Praveen-Raj-u-s/SwitchLink/README.md

# SwitchLink

SwitchLink is a Smart Switch Control Unit that goes beyond conventional remote switch control. It features a Smart USB charging system utilizing an OP Amp comparator to detect the full-charge status of connected devices. This feature is especially useful for devices and appliances lacking built-in Charge Protection Circuitry. When a device reaches full charge, SwitchLink notifies the user with defined acoustic notifications generated by a Piezo-buzzer via PWM.

## Key components and functionalities include:

* Smart USB Charging System: Monitors and indicates full-charge status using an OP Amp comparator.
* Acoustic Notifications: Utilizes a Piezo-buzzer controlled through PWM to notify users when charging is complete.
* Relay Module: Enables control of electrical switches.
* Proximity Sensors: Provides a non-contact user interface for switch control.
* Remote Control: Allows switching control over the Internet using MQTT.
* SwitchLink enhances the usability and safety of home appliances and devices, providing both manual and remote control options.

Bill of Materials: https://github.com/Praveen-Raj-u-s/SwitchLink/blob/main/Bill%20of%20Materials.BomDoc

## Critical Components:

Microcontroller (MCU):
SAMW25 Xplained Pro: This microcontroller handles all processing tasks, including sensor data acquisition, control logic, and communication. It is integrated with FreeRTOS for real-time task management and efficient operation.

image-removebg-preview

Sensors:

* VL6180X Proximity Sensors: Two proximity sensors are used for non-contact switch control. These sensors detect the presence of a hand or object near the switch, allowing for gesture-based control of the connected devices.

image-removebg-preview (1)

* OP Amp Comparator: Used in the Smart USB charging system to detect the full-charge status of connected devices. This comparator monitors the voltage level and triggers notifications when the device is fully charged.

image-removebg-preview (2)

Actuators:

* Relay Module: Controls the switching of electrical devices. The relay module is activated based on inputs from the proximity sensors or remote commands received over the Internet.

* Piezo-buzzer: Generates acoustic notifications when a device connected to the USB charging system is fully charged. The buzzer is controlled using PWM signals to create different sound patterns.

Communication Module:

 * MQTT Protocol: Enables remote control and monitoring of the switches over the Internet. The device connects to an MQTT broker, allowing users to send commands and receive status updates from anywhere with Internet access.

Power Management:

* LDO: MCP1700T converts the input of 3.3V to 4.2V to 2.8V and supplies to the VL6180X sensor whose ideal working voltage is 2.8V.

image-removebg-preview (3)

* Buck Converter: TPS62082DSGR supplies to most of the compoents a stable 3.3V from the 3.3V to 4.2V input.

image-removebg-preview (4)

## Block Diagram:



## Functional Workflow:

* Power Up: The device initializes, and the PMIC ensures stable power distribution to all components.
* Sensor Monitoring: The proximity sensors continuously monitor for user gestures to control the switches.
* Charge Detection: The OP Amp comparator monitors the voltage level of connected devices.
* User Interaction: When a proximity sensor detects a hand gesture, it sends a signal to the MCU, which activates the corresponding relay to turn the device on or off.
* Remote Commands: Users can send commands via the Internet using the MQTT protocol, allowing remote control of the switches.
* Notifications: When a device reaches full charge, the OP Amp comparator triggers the Piezo-buzzer to notify the user acoustically.

## PCB Designing:

Altium Designer was leveraged for Footprint Creation, Schematic Capture, layout, Workmanship, Gerber File generation etc.

Altium Project Link: https://upenn-eselabs.365.altium.com/designs/0D535367-1C3A-4320-998F-776AB24CDA05

## Schematics:

Main Sheet:

Switchlink Schematics-01

Memory:
  
Switchlink Schematics-02

MCU:

Switchlink Schematics-03

USB to Serial FTDI:

Switchlink Schematics-04

LIPO Charger:

Switchlink Schematics-05

Buck Converter:

Switchlink Schematics-06

Piezo-Buzzer:

Switchlink Schematics-07

LDO:

Switchlink Schematics-08

Proximity Sensor:
  
Switchlink Schematics-09

USB-C Receptor:
  
Switchlink Schematics-11

## PCB Simulation:

2D:



3D: 



## Fabrication & Assembly Files (Draftsmanship):

File Link: https://github.com/Praveen-Raj-u-s/SwitchLink/tree/main/Draftsmanship

## PCB Fabricated:

Top:





Bottom:

WhatsApp Image 2024-05-14 at 21 51 46_9ab4633a

## PCB Testing:

### Power System Evaluation:

#### Distinct Power Modes:

The device has two power sources: single cell LiPo and USB power. It has one regulator: a 3.3V buck and an LDO to provide a 2.8V for the proximity sensors. My distinct power modes would be:

Unregulated battery only is connected and ranges from 3.30V to 4.20V
Regulated USB only is connected and ranges from 4.85V to 5.25V
Both battery and USB are connected, so the USB voltage will be preferred (4.85-5.25V)

#### Power Regulation Evaluation: 

We want to determine how well (if at all!) the PCBA power regulation circuitry is working. We’ll leverage the oscilloscopes in the lab to capture various critical modes. Key questions we’ll be answering in this section are:

Are there any critical failures (i.e shorting, over voltage, etc.)?

Are we generating the voltage we expected?

Is the ripple on the output acceptable?

Setup for Evaluation:



Oscilloscope capture of the startup transient of the regulated output:



Oscilloscope capture of the steady state of the regulated output:



#### E-load testing:

We’ll load test our riskiest regulation circuit. We do not need to do load testing on all of our power regulation circuits! Only the one that is the highest risk. For example, if I have a 3.3V buck or a 12V boost, I would be more concerned about the large change in voltage required for the 12V boost.

For a chosen regulation circuit, we review our expected current load. Then, use the E-Load to evaluate the following conditions: 10%, 50%, 100%, and 120% of the expected current load. The E-Load will be measuring the actual voltage with the applied load - this is what we want to log.

logged Values: [E-Load Test Values.xlsx](https://github.com/Praveen-Raj-u-s/SwitchLink/files/15317090/E-Load.Test.Values.xlsx)

#### Thermal Evaluation under load:

With our device under load, we take an image using the thermal camera.

10% Load:



50% Load:



#### Programming the board:

JLink Debugger Connection:



Device Programming in Atemel Microchip Studio:



#### Peripheral Testing:

Now that we can program our PCBA, it is time to start bringing up the peripherals in your system. Typically, we bring the systems online one by one. For each of these following steps, we may run into failures. In such failures, we review our firmware and Altium hardware files to try to find issues. We Use the debugging tools in the lab to check for voltage, analyze serial communication, etc.

## Programming:

We use FreeRTOS for the whole implementation owing to its concurrency capabilities.

Atmel Microchip Studio Project: https://github.com/Praveen-Raj-u-s/SwitchLink/tree/main/Code%20-%20Atmel%20Microchip%20Studio%20Project

## 3D Design:

I did the CAD design in Autodesk Fusion 360 
