Praveen-Raj-u-s/SwitchLink/Schematics/Switchlink Schematics-01.png

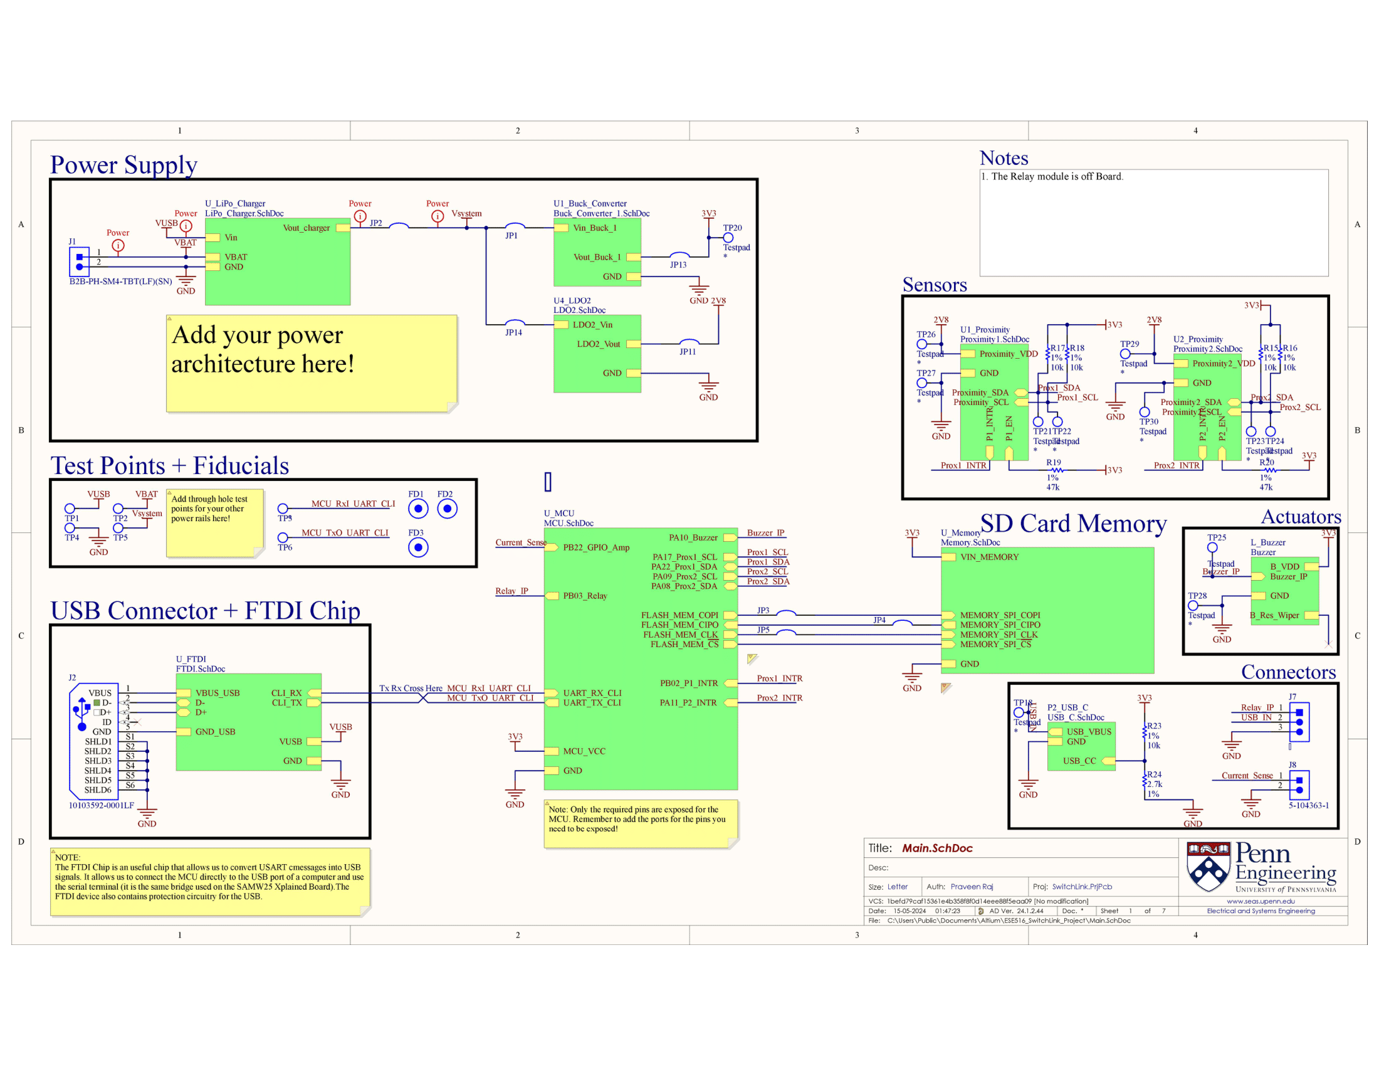
Schematics/Switchlink Schematics-01.png
