Praveen-Raj-u-s/SwitchLink/Schematics/Switchlink Schematics-02.png

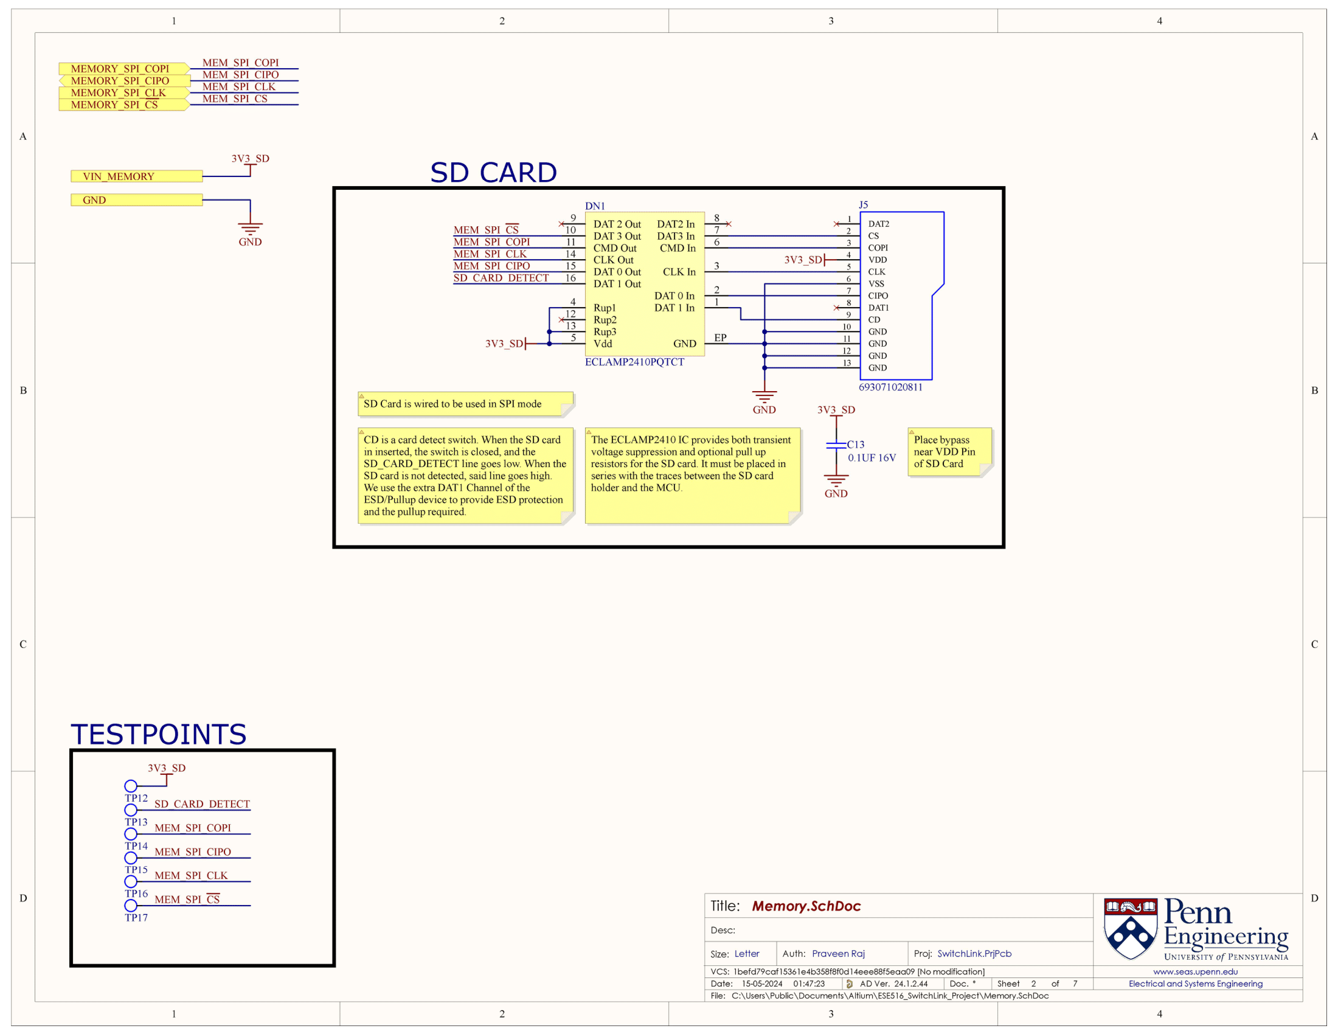
Schematics/Switchlink Schematics-02.png
