Praveen-Raj-u-s/SwitchLink/Schematics/Switchlink Schematics-03.png

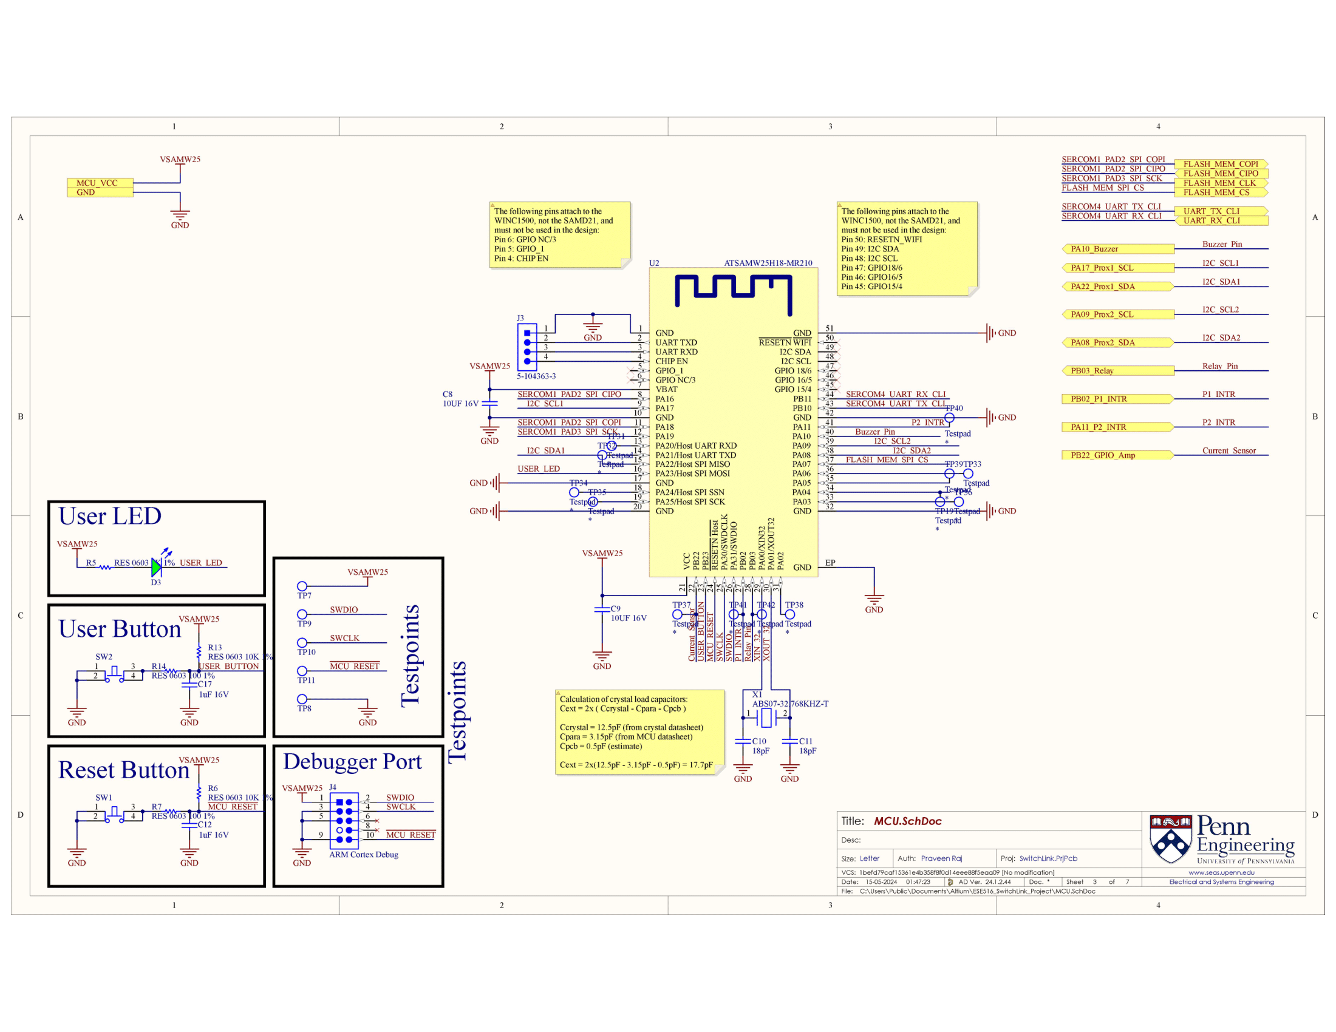
Schematics/Switchlink Schematics-03.png
