Praveen-Raj-u-s/SwitchLink/Schematics/Switchlink Schematics-04.png

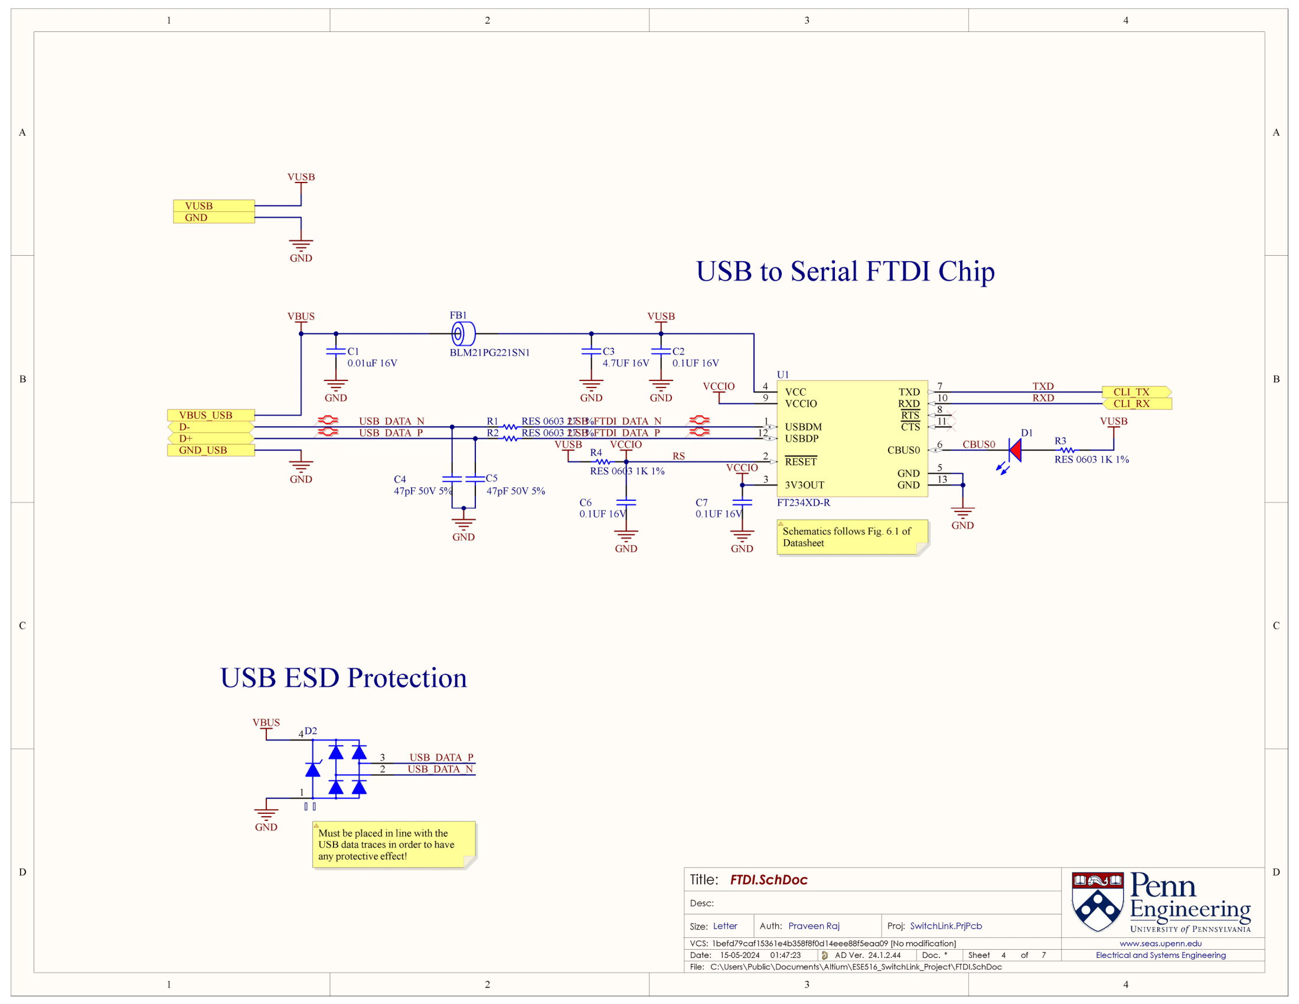
Schematics/Switchlink Schematics-04.png
