Praveen-Raj-u-s/SwitchLink/Schematics/Switchlink Schematics-05.png

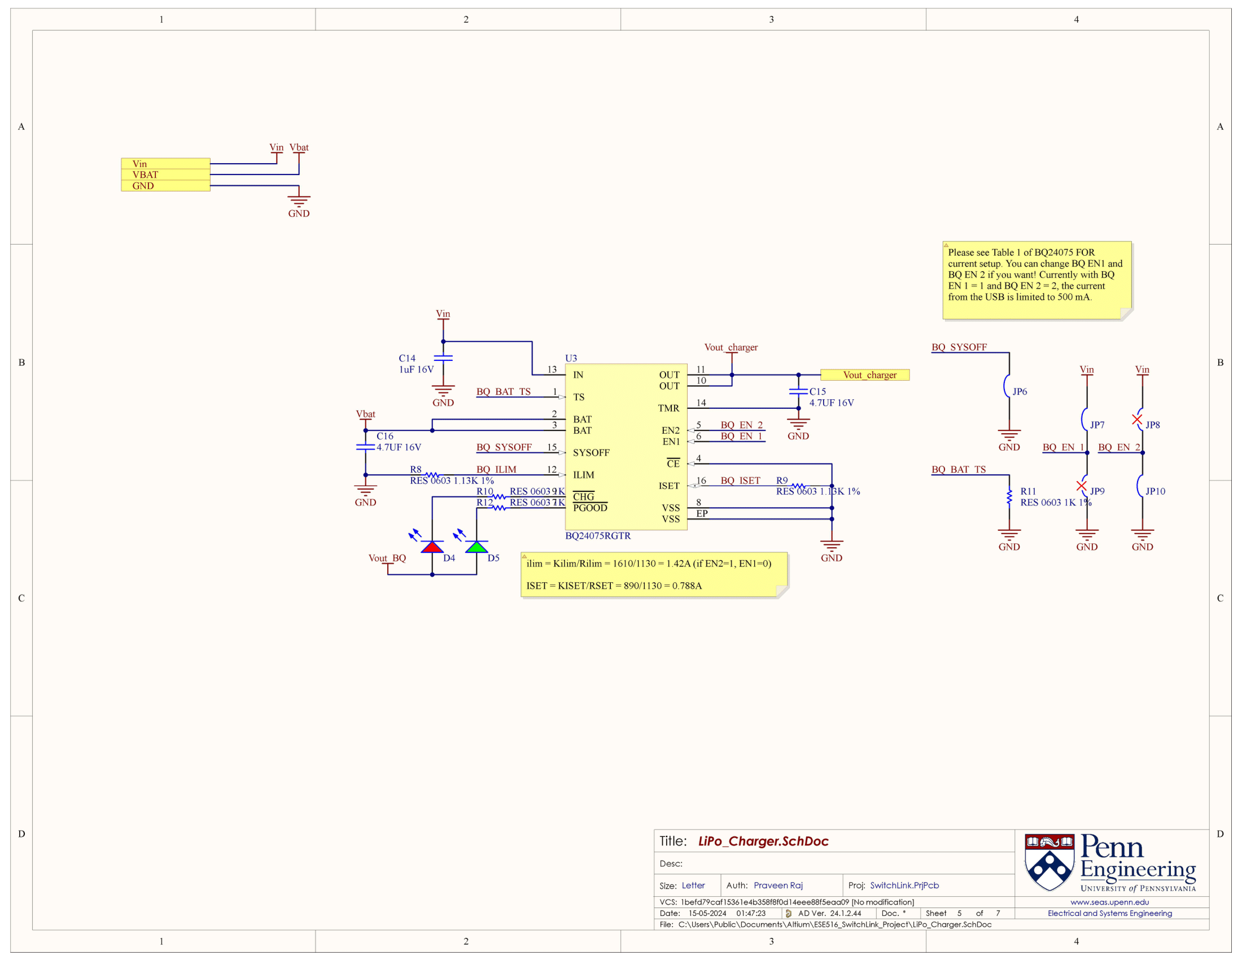
Schematics/Switchlink Schematics-05.png
