Praveen-Raj-u-s/SwitchLink/Schematics/Switchlink Schematics-06.png

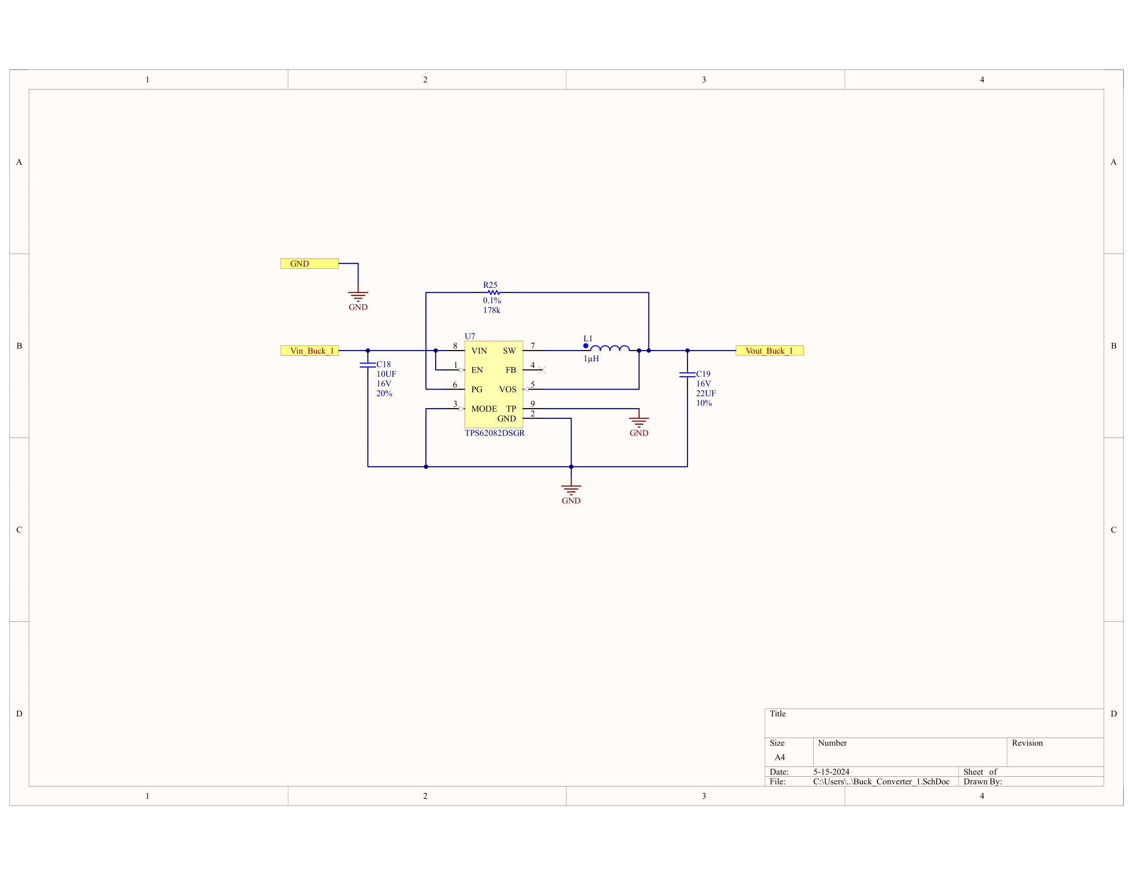
Schematics/Switchlink Schematics-06.png
