Praveen-Raj-u-s/SwitchLink/Schematics/Switchlink Schematics-07.png

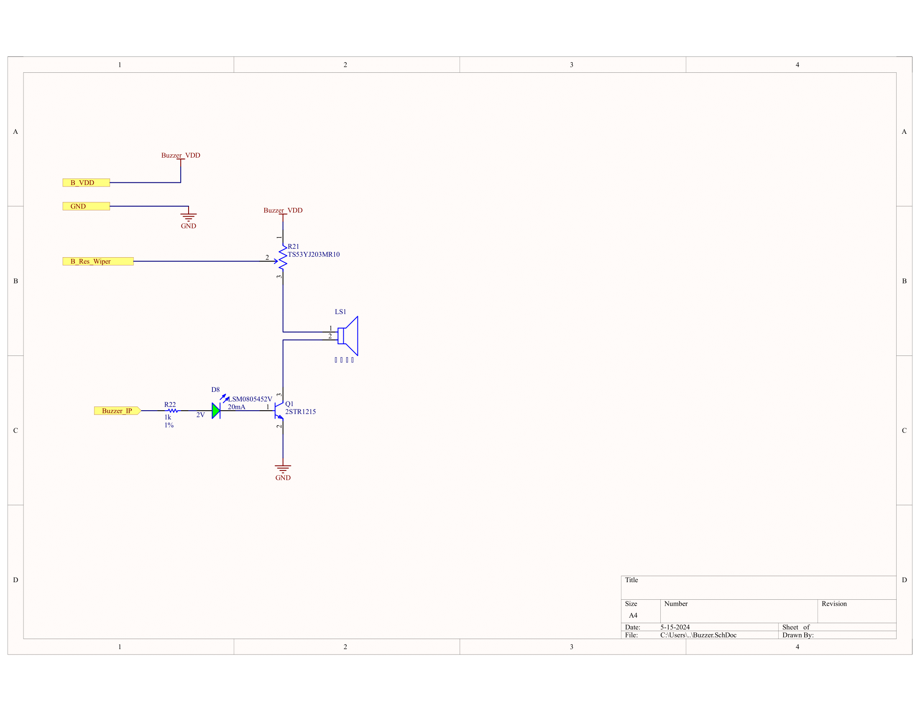
Schematics/Switchlink Schematics-07.png
