Praveen-Raj-u-s/SwitchLink/Schematics/Switchlink Schematics-08.png

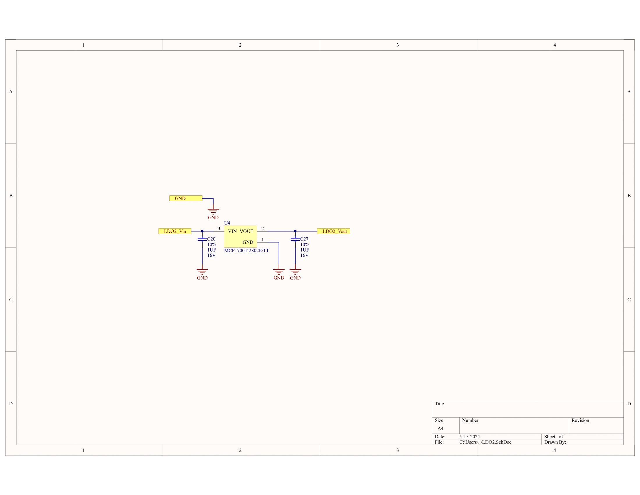
Schematics/Switchlink Schematics-08.png
