Praveen-Raj-u-s/SwitchLink/Schematics/Switchlink Schematics-09.png

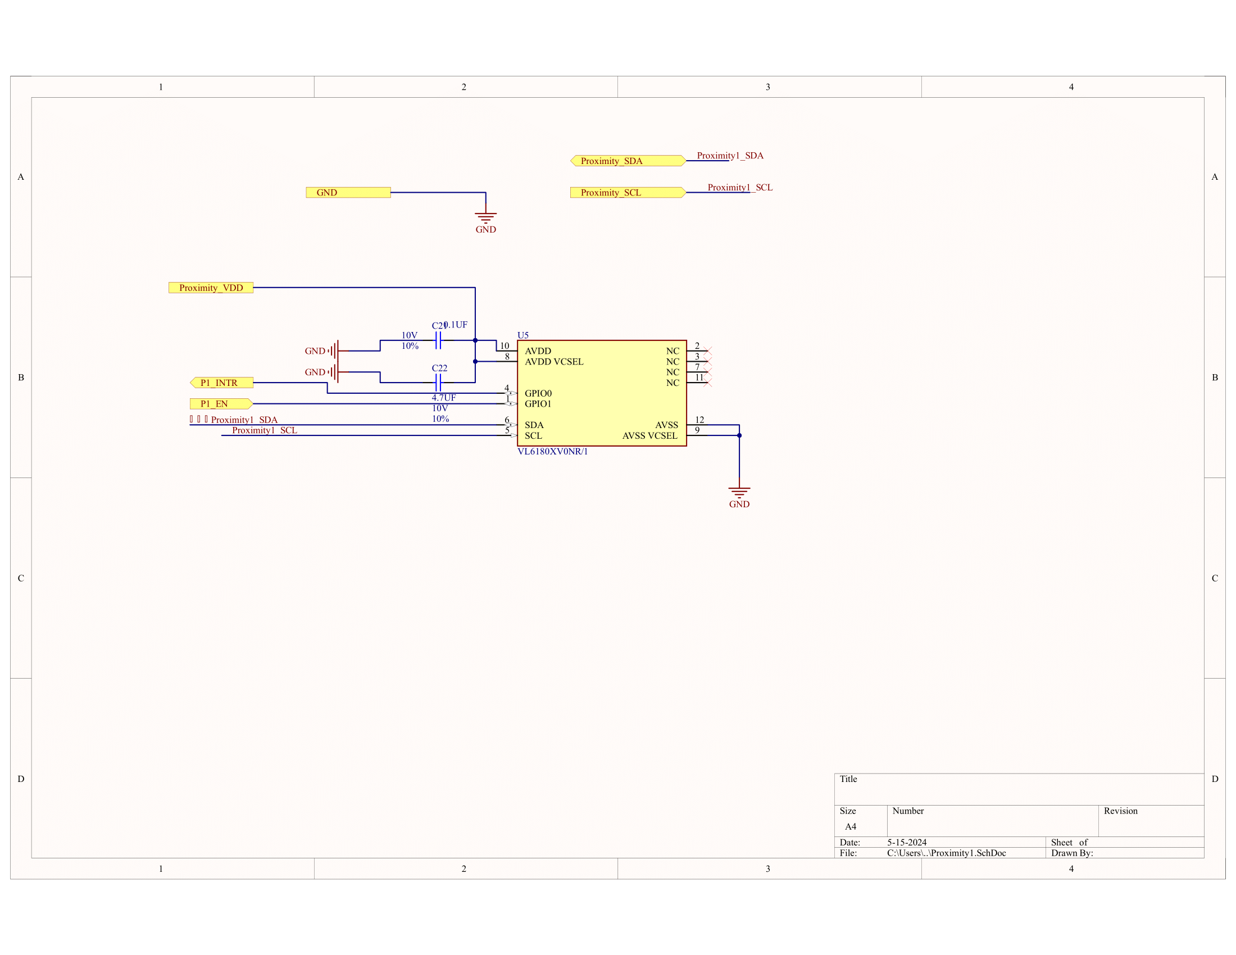
Schematics/Switchlink Schematics-09.png
