Praveen-Raj-u-s/SwitchLink/Schematics/Switchlink Schematics-10.png

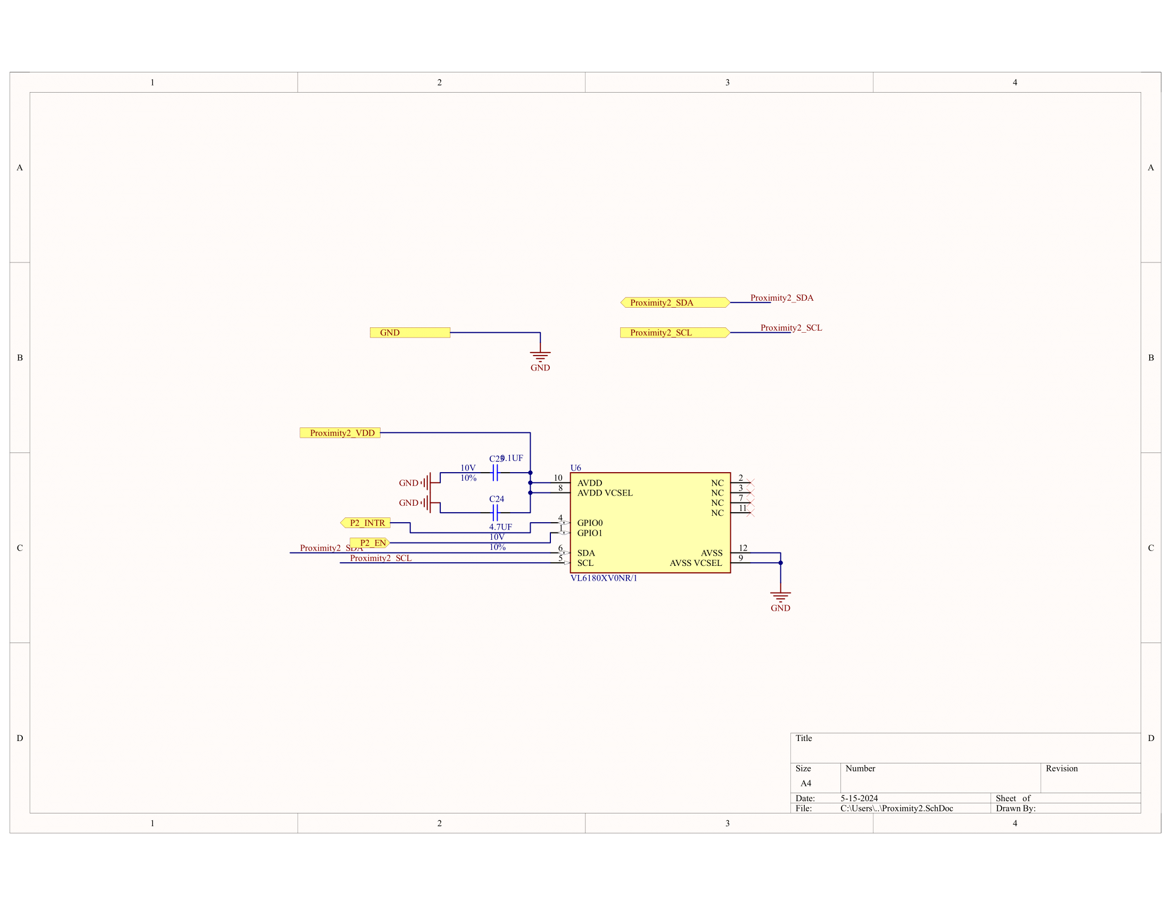
Schematics/Switchlink Schematics-10.png
