Praveen-Raj-u-s/SwitchLink/Schematics/Switchlink Schematics-11.png

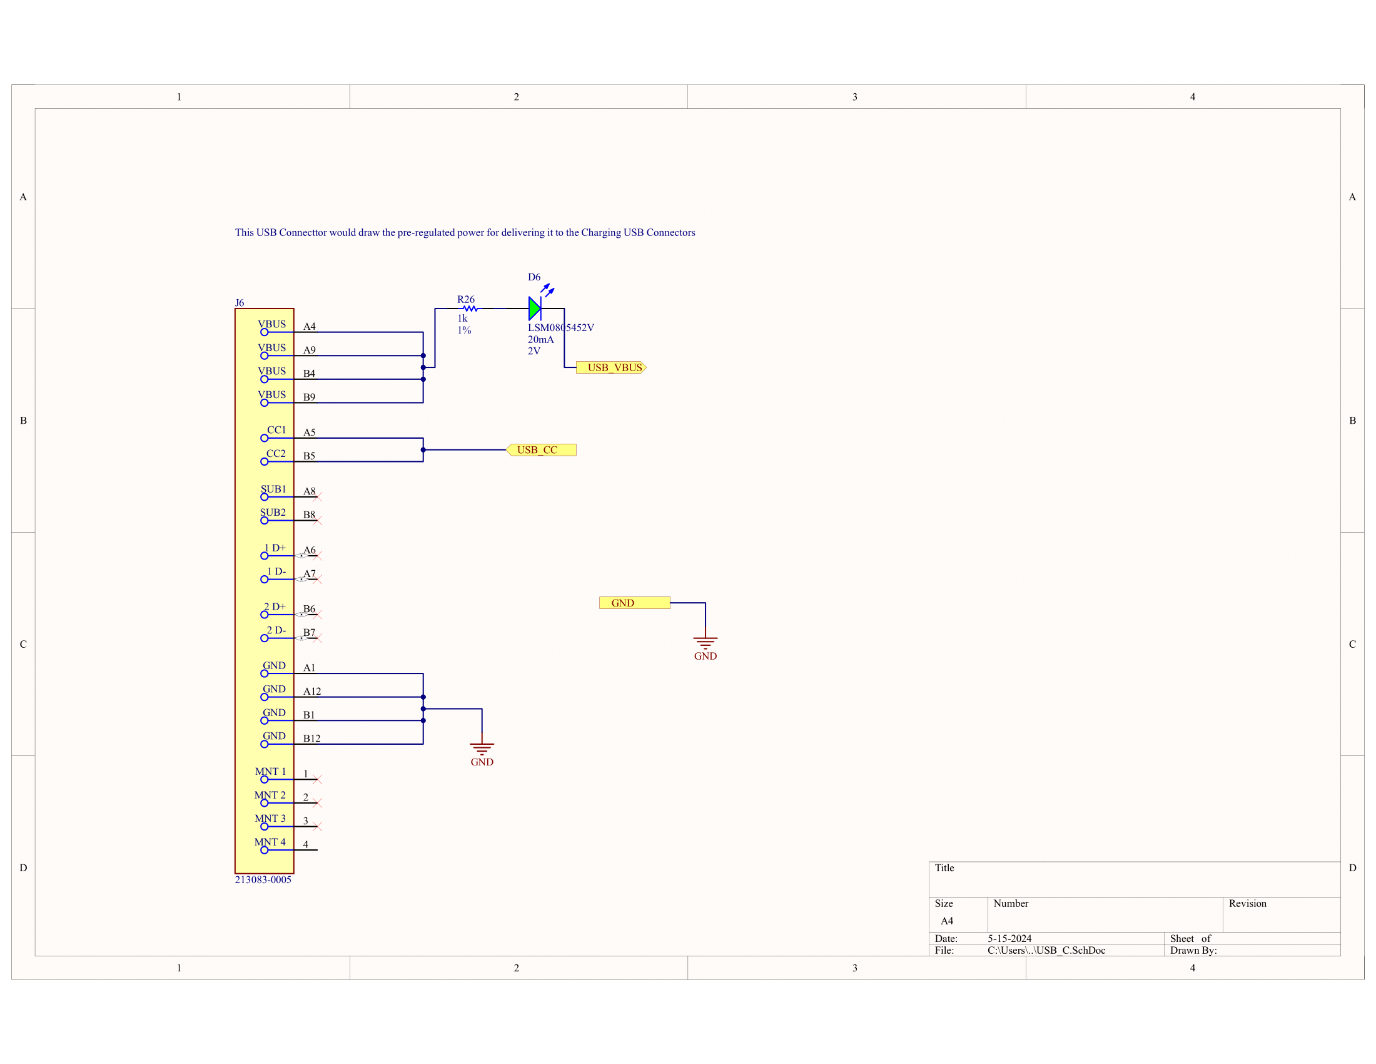
Schematics/Switchlink Schematics-11.png
