Praveen-Raj-u-s/SwitchLink/Code - Atmel Microchip Studio Project/Application/src/SerialConsole/SerialConsole.c

/**
 * @file        SerialConsole.c
 * @ingroup 	   Serial Console
 * @brief       This file has the code necessary to run the CLI and Serial Debugger. It initializes an UART channel and
 *uses it to receive command from the user as well as print debug information.
 * @details     This file has the code necessary to run the CLI and Serial Debugger. It initializes an UART channel and
 *uses it to receive command from the user as well as print debug information.
 *
 *				The code in this file will:
 *				--Initialize a SERCOM port (SERCOM # ) to be an UART channel operating at 115200 baud/second,
 *8N1
 *				--Register callbacks for the device to read and write characters asynchronously as required by
 *the CLI
 *				--Initialize the CLI and Debug Logger data structures
 *
 *				Usage:
 *
 *
 * @copyright
 * @author
 * @date        January 26, 2019
 * @version		0.1
 */

/**************************
 * Includes
 **************************/
#include "SerialConsole.h"

#include "CliThread/CliThread.h"

/**************************
 * Defines
 **************************/
#define RX_BUFFER_SIZE 512  ///< Size of character buffer for RX, in bytes
#define TX_BUFFER_SIZE 512  ///< Size of character buffers for TX, in bytes

char debugBuffer[128];

/**************************
 * Structures and Enumerations
 **************************/
cbuf_handle_t cbufRx;  ///< Circular buffer handler for receiving characters from the Serial Interface
cbuf_handle_t cbufTx;  ///< Circular buffer handler for transmitting characters from the Serial Interface

char latestRx;  ///< Holds the latest character that was received
char latestTx;  ///< Holds the latest character to be transmitted.

/**************************
 *  Callback Declaration
 **************************/
void usart_write_callback(struct usart_module *const usart_module);  // Callback for when we finish writing characters to UART
void usart_read_callback(struct usart_module *const usart_module);   // Callback for when we finis reading characters from UART

/**************************
 * Local Function Declaration
 **************************/
static void configure_usart(void);
static void configure_usart_callbacks(void);

/**************************
 * Global Local Variables
 **************************/
struct usart_module usart_instance;
char rxCharacterBuffer[RX_BUFFER_SIZE];                 ///< Buffer to store received characters
char txCharacterBuffer[TX_BUFFER_SIZE];                 ///< Buffer to store characters to be sent
enum eDebugLogLevels currentDebugLevel = LOG_INFO_LVL;  ///< Variable that holds the level of debug log messages to show. Defaults to showing all debug values

/**************************
 * Global Functions
 **************************/

/**
 * @fn			void InitializeSerialConsole(void)
 * @brief		Initializes the UART - sets up the SERCOM to act as UART and registers the callbacks for
 *				asynchronous reads and writes.
 * @details		Initializes the UART - sets up the SERCOM to act as UART and registers the callbacks for
 *				asynchronous reads and writes.
 * @note			Call from main once to initialize Hardware.
 */

void InitializeSerialConsole(void)
{
    // Initialize circular buffers for RX and TX
    cbufRx = circular_buf_init((uint8_t *)rxCharacterBuffer, RX_BUFFER_SIZE);
    cbufTx = circular_buf_init((uint8_t *)txCharacterBuffer, RX_BUFFER_SIZE);

    // Configure USART and Callbacks
    configure_usart();
    configure_usart_callbacks();

    usart_read_buffer_job(&usart_instance, (uint8_t *)&latestRx, 1);  // Kicks off constant reading of characters

    // Add any other calls you need to do to initialize your Serial Console
}

/**
 * @fn			void DeinitializeSerialConsole(void)
 * @brief		Deinitlaises the UART
 * @note
 */
void DeinitializeSerialConsole(void)
{
    usart_disable(&usart_instance);
}

/**
 * @fn			void SerialConsoleWriteString(const char * string)
 * @brief		Writes a string to be written to the uart. Copies the string to a ring buffer that is used to hold the
 *text send to the uart
 * @details		Uses the ringbuffer 'cbufTx', which in turn uses the array 'txCharacterBuffer'. Modified to be
 *thread safe.
 * @note			Use to send a string of characters to the user via UART
 */
void SerialConsoleWriteString(const char *string)
{
    vTaskSuspendAll();
    if (string != NULL) {
        for (size_t iter = 0; iter < strlen(string); iter++) {
            circular_buf_put(cbufTx, string[iter]);
        }

        if (usart_get_job_status(&usart_instance, USART_TRANSCEIVER_TX) == STATUS_OK) {
            circular_buf_get(cbufTx, (uint8_t *)&latestTx);  // Perform only if the SERCOM TX is free (not busy)
            usart_write_buffer_job(&usart_instance, (uint8_t *)&latestTx, 1);
        }
    }
    xTaskResumeAll();
}

/**
 * @fn			int SerialConsoleReadCharacter(uint8_t *rxChar)
 * @brief		Reads a character from the RX ring buffer and stores it on the pointer given as an argument.
 *				Also, returns -1 if there is no characters on the buffer
 *				This buffer has values added to it when the UART receives ASCII characters from the terminal
 * @details		Uses the ringbuffer 'cbufTx', which in turn uses the array 'txCharacterBuffer'
 * @param[in]	Pointer to a character. This function will return the character from the RX buffer into this pointer
 * @return		Returns -1 if there are no characters in the buffer
 * @note			Use to receive characters from the RX buffer (FIFO)
 */
int SerialConsoleReadCharacter(uint8_t *rxChar)
{
    vTaskSuspendAll();
    int a = circular_buf_get(cbufRx, (uint8_t *)rxChar);
    xTaskResumeAll();
    return a;
}

/*
DEBUG LOGGER FUNCTIONS
*/

/**
 * @fn			eDebugLogLevels getLogLevel(void)
 * @brief		Gets the level of debug to print to the console to the given argument.
 *				Debug logs below the given level will not be allowed to be printed on the system
 * @return		Returns the current debug level of the system.
 * @note
 */

enum eDebugLogLevels getLogLevel(void)
{
    return currentDebugLevel;
}

/**
 * @fn			eDebugLogLevels getLogLevel(void)
 * @brief		Sets the level of debug to print to the console to the given argument.
 *				Debug logs below the given level will not be allowed to be printed on the system
 * @param[in]   debugLevel The debug level to be set for the debug logger
 * @note
 */
void setLogLevel(enum eDebugLogLevels debugLevel)
{
    currentDebugLevel = debugLevel;
}

/**
 * @fn			LogMessage (Students to fill out this)
 * @brief
 * @note
 */
void LogMessage(enum eDebugLogLevels level, const char *format, ...)
{
    if (getLogLevel() <= level) {
        va_list ap;
        va_start(ap, format);
        vsnprintf(debugBuffer, 127, format, ap);
        SerialConsoleWriteString(debugBuffer);
        va_end(ap);
    }
};

/**
 * @fn			LogMessage Debug
 * @brief
 * @note
 */
void LogMessageDebug(const char *format, ...)
{
    LogMessage(LOG_DEBUG_LVL, format);
};

/*
COMMAND LINE INTERFACE COMMANDS
*/

/**************************
 * Local Functions
 **************************/

/**
 * @fn			static void configure_usart(void)
 * @brief		Code to configure the SERCOM "EDBG_CDC_MODULE" to be a UART channel running at 115200 8N1
 * @note
 */
static void configure_usart(void)
{
    struct usart_config config_usart;
    usart_get_config_defaults(&config_usart);

    config_usart.baudrate = 115200;
    config_usart.mux_setting = EDBG_CDC_SERCOM_MUX_SETTING;
    config_usart.pinmux_pad0 = EDBG_CDC_SERCOM_PINMUX_PAD0;
    config_usart.pinmux_pad1 = EDBG_CDC_SERCOM_PINMUX_PAD1;
    config_usart.pinmux_pad2 = EDBG_CDC_SERCOM_PINMUX_PAD2;
    config_usart.pinmux_pad3 = EDBG_CDC_SERCOM_PINMUX_PAD3;
    while (usart_init(&usart_instance, EDBG_CDC_MODULE, &config_usart) != STATUS_OK) {
    }

    usart_enable(&usart_instance);
}

/**
 * @fn			static void configure_usart_callbacks(void)
 * @brief		Code to register callbacks
 * @note
 */
static void configure_usart_callbacks(void)
{
    usart_register_callback(&usart_instance, usart_write_callback, USART_CALLBACK_BUFFER_TRANSMITTED);
    usart_register_callback(&usart_instance, usart_read_callback, USART_CALLBACK_BUFFER_RECEIVED);
    usart_enable_callback(&usart_instance, USART_CALLBACK_BUFFER_TRANSMITTED);
    usart_enable_callback(&usart_instance, USART_CALLBACK_BUFFER_RECEIVED);
}

/**************************
 * Callback Functions
 **************************/

/**
 * @fn			void usart_read_callback(struct usart_module *const usart_module)
 * @brief		Callback called when the system finishes receives all the bytes requested from a UART read job
 * @note
 */
void usart_read_callback(struct usart_module *const usart_module)
{
    circular_buf_put(cbufRx, (uint8_t)latestRx);                      // Add the latest read character into the RX circular Buffer
    usart_read_buffer_job(&usart_instance, (uint8_t *)&latestRx, 1);  // Order the MCU to keep reading
    CliCharReadySemaphoreGiveFromISR();                               // Give binary semaphore
}

/**
 * @fn			void usart_write_callback(struct usart_module *const usart_module)
 * @brief		Callback called when the system finishes sending all the bytes requested from a UART read job
 * @note
 */
void usart_write_callback(struct usart_module *const usart_module)
{
    if (circular_buf_get(cbufTx, (uint8_t *)&latestTx) != -1)  // Only continue if there are more characters to send
    {
        usart_write_buffer_job(&usart_instance, (uint8_t *)&latestTx, 1);
    }
}

struct usart_module *GetUsartModule(void)
{
    return &usart_instance;
}
