Praveen-Raj-u-s/SwitchLink/Code - Atmel Microchip Studio Project/Application/src/voltagesense/vsense.h

/*
 * vsense.h
 *
 * Created: 30-04-2024 04:01:20
 *  Author: Praveen Raj U S
 */ 


#ifndef VSENSE_H_
#define VSENSE_H_


void configure_adc(void);
void read_adc(void);
void volt(void);
void configure_gpio(void);


#endif /* VSENSE_H_ */
